munanqiu/ING_RF_Tester/README.md

# ING_RF_Tester
目录说明

01-bin for MCU：golden线路板的烧写固件

02-sch-pcb：golden的原理和pcb源文件

03-upper software：上位机测试软件

04-doc：说明文档
