munanqiu/ING_RF_Tester/(list of files, drawings)

Other design files:
02-sch-pcb/Layout.pcb
