munanqiu/ING_RF_Tester/01-bin for MCU/evk-916/flash_download.ini

[main]
family=ing918
timeout=10000
MIN_ADDR=16384
MAX_ADDR=540671

[options]
download=1
verify=0
redownload=1
set-entry=1
launch=1
batch=0
script=
entry=0x4000
protection.enabled=0
protection.unlock=0
UseScript=0
batch.current=0
batch.limit=-1

[uart]
Baud=460800
Port=11
Parity=
DataBits=8
StopBits=1
Timeout=10000

[bin-0]
Name=Burn Bin #1
Checked=1
FileName=platform.bin
Address=16384

[bin-1]
Name=Burn Bin #2
Checked=1
Address=155648
FileName=RF_Tester_9188.bin

[bin-2]
Name=Burn Bin #3
Checked=1
FileName=merge916.bin
Address=262144

[bin-3]
Name=Burn Bin #4
Checked=0
FileName=
Address=16384

[bin-4]
Name=Burn Bin #5
Checked=0
FileName=
Address=16384

[bin-5]
Name=Burn Bin #6
Checked=0
FileName=
Address=16384
