munanqiu/ING_RF_Tester/01-bin for MCU/downloader/settings.ini

[uart]
Port=COM1
Baud=115200
Parity=
DataBits=8
StopBits=1
Timeout=10000

[options]
script=
download=1
verify=1
redownload=1
entry=0x4000
set-entry=1
launch=1
ResetReservedFlash=0
protection.enabled=0
protection.unlock=0
writeprotection.enabled=0
UseScript=0
ExtFlashType=0
AlwaysUseExtBootloader=0
USBDelayBeforeReopen=500
batch=1
batch.current=0
batch.limit=-1

[bin-0]
Name=Burn Bin #1
Checked=0
FileName=
Address=16384

[bin-1]
Name=Burn Bin #2
Checked=0
FileName=
Address=16384

[bin-2]
Name=Burn Bin #3
Checked=0
FileName=
Address=16384

[bin-3]
Name=Burn Bin #4
Checked=0
FileName=
Address=16384

[bin-4]
Name=Burn Bin #5
Checked=0
FileName=
Address=16384

[bin-5]
Name=Burn Bin #6
Checked=0
FileName=
Address=16384

[main]
timeout=5000
MIN_ADDR=16384
MAX_ADDR=540671
