munanqiu/ING_RF_Tester/(commit log)

2025-06-20 第一次上传
    [Layout.pcb, ingchips_golden.sch]
2025-06-27 更新版本为1.0.01
2025-07-01 增加了烧写完成之后发送DUT的UID功能，版本为1.2.1
2025-07-01 增加读取uid
2025-07-02 更新了产测环境搭建说明文档，增加了UID读取等部分
2025-07-02 Revert "更新了产测环境搭建说明文档，增加了UID读取等部分"
    This reverts commit ac71f0e13b601e0356148ee611f7c6f0b6fea82b.
2025-07-02 更新产测环境搭建说明
2025-07-02 删除老版本上位机工具
2025-07-07 更新版本号为1.3.1，将烧录频偏值放在vendor程序烧录之后
    烧录校验值为频偏值本身和0xFF异或的值
2025-07-09 增加日志显示开关，修改异常显示颜色
2025-07-14 更新版本号为1.4.1，将tune值烧录放在了测试z中
2025-07-14 添加了上电显示'A'
2025-07-17 更新版本号为1.4.2，增加了连接检测的超时机制
2025-07-17 减少了上电检查连接状态的重试次数和时间
2025-08-06 更新版本号为1.5.2，增加了透传模式，上位机可以通过evk直接和DUT交互
2025-08-08 更新evk接收灵敏度阈值判读，现在认为灵敏度与阈值相等也通过测试
2025-08-21 evk适配了918测试固件的烧写，版本号变更为1.6.1
2025-08-21 删除多余文件
2025-08-21 上传downloader工具
2025-08-22 更新环境搭建说明，增加了上位机说明
2026-03-27 916: Tester=v1.7.1, Tool=v1.7.3
    优化916烧录测试速度，从20s优化为15s，更新内容：
    1. golden程序；
    2. 上位机工具；
    3. dut的下载地址从0x38000改为0x40000；
2026-06-09 兼容920（ING208X）系列芯片测试
